JosefR/can-node/README.md

# can-node

A simple STM32F072 evaluation board with temperature and humidity sensors and a CAN interface. 

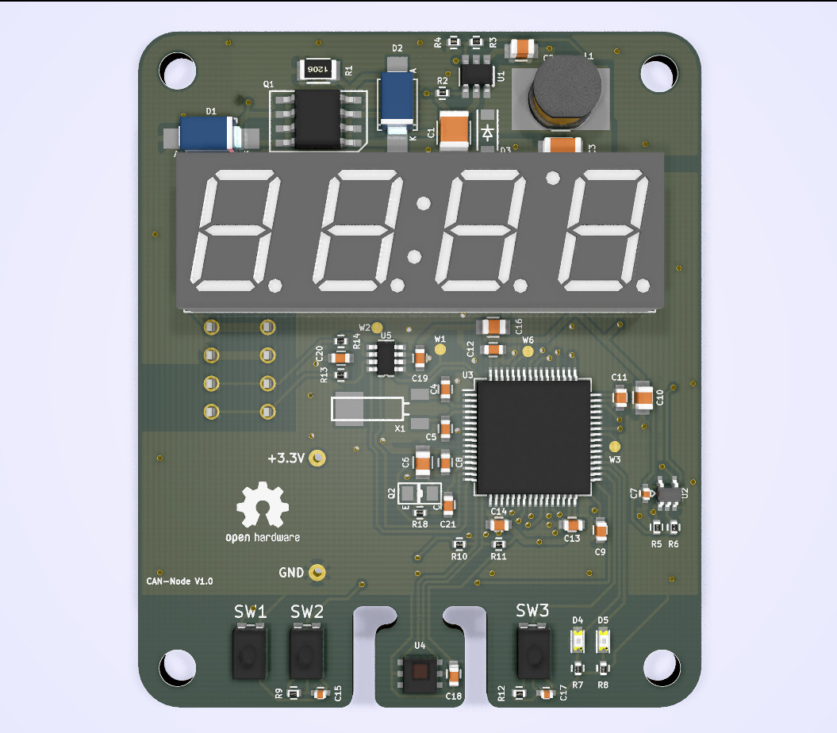
[picture p1: can-node.jpg]
can-node board
