JosefR/can-node/bom.ods

Reference | Count | Part | Manufacturer | Manufacturer Part Number | Package | Distributor | Distributor link | Cost
AFF1 | 1 | 4 digit 7-segment LED display | Lite-On | LTC-4627JR |  | Mouser | http://www.mouser.de/ProductDetail/Lite-On/LTC-4627JR/ | 1.85 | 1.85 |  | M | 5
C1 | 1 | 2.2 µF, >40V | Murata | GRM32ER72A225KA35L | 1210 | Reichelt | http://www.reichelt.de/Vielschicht-SMD-G1210-High-Cap/X7R-G1210-2-2/3/index.html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 | 0.3 | 0.3
C2 | 1 | 100 nF >10V | Yageo | CC0805KRX7R9BB104 | 0805 | Reichelt | http://www.reichelt.de/Vielschicht-SMD-G0805/X7R-G0805-100N/3/index.html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 | 0.04 | 0.04
C20 | 1 | 4,7nF | Yageo | CC0603KRX7R9BB472 | 0603 | Reichelt | http://www.reichelt.de/Vielschicht-SMD-G0603/X7R-G0603-4-7N/3/index.html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 | 0.04 | 0.04
C3 | 1 | 22µF | MuRata | GRM31CR71A226KE15L | 1206 | Reichelt | http://www.reichelt.de/Vielschicht-SMD-G1206-High-Cap/X7R-G1206-22-10/3/index.html?ACTION=3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 | 0.19 | 0.19
C4, C5 | 2 | 15pF | Wurth | 885012006052 | 0603 | Mouser | http://www.mouser.de/Search/ProductDetail.aspx | 0.057 | 0.114 |  | M | 12
C6, C10, C16 | 3 | 4.7µF | Yageo | CC0805KRX7R9BB472 | 0805 | Reichelt | http://www.reichelt.de/Vielschicht-SMD-G0805/X7R-G0805-4-7N/3/index.html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 | 0.04 | 0.12
C7, C8, C9, C11, C12, C13, C14, C15, C17, C18, C19, C21 | 12 | 100nF | Yageo | CC0603KRX7R7BB104 | 0603 | Mouser | http://www.mouser.de/ProductDetail/Yageo/CC0603KRX7R7BB104/ | 0.094 | 1.128 |  | M | 100
C22 | 1 | 0.1F |  |  | 10mm pitch | Reichelt | http://www.reichelt.de/Speicher-Elkos/SPK-100-000-10/3/index.html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 | 0.99 | 0.99
D1 | 1 | TVS-Diode, 40.2 V | Vishay | P4SMA47CA | DO-214AC | Mouser | http://www.mouser.de/ProductDetail/Vishay-Semiconductors/P4SMA47CA-E3-61/ | 0.377 | 0.377 |  | M | 7
D2 | 1 | Zener Diode 10V | ON Semiconductor | 1SMA5925BT3G | SMA | Mouser | http://www.mouser.de/ProductDetail/ON-Semiconductor/1SMA5925BT3G/ | 0.358 | 0.358 |  | M | 7
D3 | 1 | 0.57V 1A | NXP Semiconductor | PMEG6010CEH,11 | SOD-123F | Mouser | http://www.mouser.de/ProductDetail/NXP/PMEG6010CEH115/ | 0.358 | 0.358 | M | M | 7
D4,D5 | 2 | LED Rot | Osram |  | 0603 | Reichelt | http://www.reichelt.de/SMD-LEDs-Standard/LS-Q976/3/index.html?ACTION=3&GROUPID=3035&ARTICLE=156367&OFFSET=75 | 0.06 | 0.12
D6 | 1 | Schottky Diode 0.3V | Fairchield | MBR1020VL | SOD-123 | Mouser | http://www.mouser.de/ProductDetail/Fairchild-Semiconductor/MBR1020VL/ | 0.368 | 0.368 |  | M | 10
L1 | 1 | 27µH | Bourns | SDE0604A-270M |  | Mouser | http://www.mouser.de/ProductDetail/Bourns/SDE0604A-270M/ | 0.474 | 0.474 |  | M | 5
P1 | 1 | Micro Match Header 2x5 |  |  |  | Reichelt | http://www.reichelt.de/Micro-Match-Verbinder/MPE-374-1-010/3/index.html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 | 0.41 | 0.41
P2 | 1 |  | WAGO | 218-104 |  | Voelkner | http://www.voelkner.de/products/55717/Leiterplattenklemme-218-4-polig-Rm-2-5.html?products_model=D57985 | 2.08 | 2.08
Q1 | 1 | P-Mos | Diodes Incorporated | DMP6023LSS |  | Mouser | http://www.mouser.de/ProductDetail/Diodes-Incorporated/DMP6023LSS-13/?qs=jXf%2FRVhl83Yh%252bCazOhYmSQ%3D%3D | 0.74 | 0.74 |  | M | 5
Q2 | 1 | Fototransistor | Osram | SFH 3711 |  | Mouser | http://www.mouser.de/ProductDetail/Osram-Opto-Semiconductor/SFH-3711/ | 0.61 | 0.61 |  | M | 5
Q3, Q4, Q5, Q6, Q7, Q8, Q9, Q10 | 8 | N-Mos |  | BSS138 | SOT-23 | Reichelt | http://www.reichelt.de/BS-Transistoren/BSS-138-SMD/3/index.html?ACTION=3&GROUPID=2884&ARTICLE=41437&OFFSET=75 | 0.05 | 0.4
Q11, Q12, Q13, Q14, Q15 | 5 | P-Mos |  | BSS64P | SOT-23 | Reichelt | http://www.reichelt.de/BS-Transistoren/BSS-84P-SMD/3/index.html?ACTION=3&GROUPID=2884&ARTICLE=41443&OFFSET=75 | 0.05 | 0.25
R1 | 1 | 100 kΩ, >=0.1W | Yageo | RC1206JR-07100KL | 1206 | Reichelt | http://www.reichelt.de/SMD-1206-von-1-bis-910-kOhm/SMD-1-4W-100K/3/index.html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 | 0.03 | 0.03
R13, R14 | 2 | 60.4 kΩ | Vishay Dale | CRCW040260R4FKED | 0402 | Mouser | http://www.mouser.de/ProductDetail/Vishay/CRCW040260R4FKED/ | 0.094 | 0.188 |  | M | 10
R18 | 1 | 4.7 kΩ | Yageo | RC0402FR-074K7L | 0402 | Reichelt | http://www.reichelt.de/SMD-0402-von-1-bis-910-kOhm/SMD-0402-4-7K/3/index.html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 | 0.03 | 0.03
R2 | 1 | 100 kΩ, 5% | Yageo | RC0402FR-07100KL | 0402 | Reichelt | http://www.reichelt.de/SMD-0402-von-1-bis-910-kOhm/SMD-0402-100K/3/index.html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 | 0.03 | 0.03
R25, R26, R27, R28, R33, R34, R35, R36 | 8 | 120 Ω | Yageo | RC0402FR-07120RL | 0402 | Reichelt | http://www.reichelt.de/SMD-0402-von-0-bis-910-Ohm/SMD-0402-120/3/index.html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 | 0.03 | 0.24
R3 | 1 | 28 kΩ, 1% | Vishay Dale | CRCW040228K0FKED | 0402 | Mouser | http://www.mouser.de/ProductDetail/Vishay/CRCW040228K0FKED/?qs=sGAEpiMZZMu61qfTUdNhG2DpbjADlD3GUol6Srswoic%3d | 0.094 | 0.094 |  | M | 10
R4 | 1 | 8.45 kΩ, 1% | Vishay Dale | CRCW04028K45FKED | 0402 | Mouser | http://www.mouser.de/ProductDetail/Vishay/CRCW04028K45FKED/ | 0.094 | 0.094 |  | M | 10
R5, R6 | 2 | 10 kΩ | Yageo | RC0402FR-0710KL | 0402 | Reichelt | http://www.reichelt.de/SMD-0402-von-1-bis-910-kOhm/SMD-0402-10K/3/index.html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 | 0.03 | 0.06
R7, R8 | 2 | 220 Ω | Yageo | RC0402FR-07220RL | 0402 | Reichelt | http://www.reichelt.de/SMD-0402-von-0-bis-910-Ohm/SMD-0402-220/3/index.html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 | 0.03 | 0.06
R9, R10, R11, R12 | 2 | 3.3 kΩ | Yageo | RC0402FR-073K3L | 0402 | Reichelt | http://www.reichelt.de/SMD-0402-von-1-bis-910-kOhm/SMD-0402-3-3K/3/index.html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 | 0.03 | 0.06
R15 | 1 | 100 Ω > 0.11W | Yageo | RC0805FR-07100RL | 0805 | Reichelt | http://www.reichelt.de/SMD-0805-von-0-bis-910-Ohm/SMD-0805-100/3/index.html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 | 0.3 | 0.3
SW1, SW2, SW3 | 3 | Button |  |  | KMR2 | Reichelt | http://www.reichelt.de/Kurzhubtaster/KMR-231-G-LFS/3/index.html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 | 0.25 | 0.75
U1 | 1 | LMR16006 | Texas Instruments | LMR16006XDDCR | TI-DDC | Mouser | http://www.mouser.de/ProductDetail/Texas-Instruments/LMR16006XDDCR/ | 2.7 | 2.7
U2 | 1 | SN74LVC1G08 | Texas Instruments | SN74LVC1G08DCKR | TI-DCK | Mouser | http://www.mouser.de/ProductDetail/Texas-Instruments/SN74LVC1G08DCKR/ | 0.387 | 0.387
U3 | 1 | STM32F072RB | ST Microelectronics | STM32F072RBT6 | LQFP64 | Mouser | http://www.mouser.de/ProductDetail/STMicroelectronics/STM32F072RBT6/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 | 3.7 | 3.7
U4 | 1 | HDC1080 | Texas Instruments |  | DMB | Mouser | http://www.mouser.de/ProductDetail/Texas-Instruments/HDC1080DMBR/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 | 2.7 | 2.7
U5 | 1 | TCAN334 | Texas Instruments | TCAN334DCNT | TI-DCN | Mouser | http://www.mouser.de/ProductDetail/Texas-Instruments/TCAN334DCNT/ | 2.26 | 2.26
X1 | 1 | 32,768kHz, 12.5pF | MICRO CRYSTAL | MS1V-T1K 32.768KHZ 12,5PF |  | Reichelt | http://www.reichelt.de/Uhrenquarze-SMD-Gehaeuse/32-768-MS1V-12-5/3/index.html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 | 0.39 | 0.39
 |  |  |  |  |  |  |  |  | 25.39
