JosefR/can-node/case/thermostat.fcstd

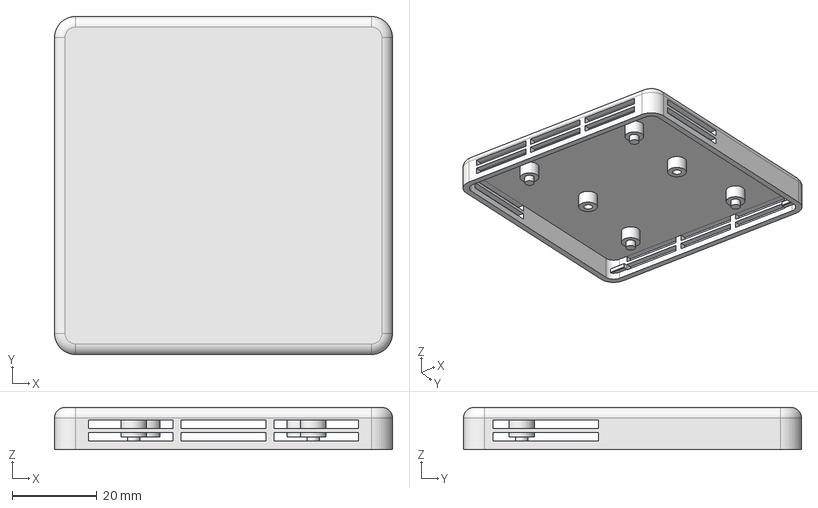
[picture p2: CAD file, 2016-12-29]
case/thermostat.fcstd
80.0 x 80.0 x 10.0 mm
