JosefR/can-node/can-node.kicad_pcb

## KiCad design can-node.kicad_pcb (2018-07-14)

Schematic: can-node.sch, CAN Node

Parts:
P2: CONN_01X04; WAGO_218-104

Connections:
CANH_IN: P2.4; also elsewhere on the board
CANL_IN: P2.3; also elsewhere on the board
GND: P2.2; also elsewhere on the board
VIN+: P2.1; also elsewhere on the board

Schematic: power.sch, CAN Node

Parts:
C1: 2.2µF; C_2010_5025Metric_Pad1.52x2.65mm_HandSolder
C2: 100n >10V; C_0603_1608Metric_Pad1.05x0.95mm_HandSolder; Rating >10V
C3: 22µF; C_1206_3216Metric_Pad1.42x1.75mm_HandSolder
C22: 0.1F; C_Radial_D13_L7_P10
D1: 40.2V; D_SMA_Handsoldering; Part P4SMA47CA
D2: 1A, 50V; D_SMF_Handsoldering; MPN SS1FN6
D3: 0.57V 1A; D_SOD-123_HandSoldering
D6: 0.3V; D_SOD-123_HandSoldering
L1: 27µH 220mΩ; SDE0604A_HandSoldering
R2: 100k; R_0603_1608Metric_Pad1.05x0.95mm_HandSolder
R3: 28k 1%; R_0603_1608Metric_Pad1.05x0.95mm_HandSolder
R4: 8.45k 1%; R_0603_1608Metric_Pad1.05x0.95mm_HandSolder
R15: 100; R_0805_2012Metric_Pad1.33x1.40mm_HandSolder
U1: LMR16006; TI-DDC_HandSoldering
W8: VINB; Measurement_Point_tiny
W9: VINC; Measurement_Point_tiny
W10: FB; Measurement_Point_tiny
W11: SW; Measurement_Point_tiny
W12: +3.3V; Measurement_Point_tiny
W15: 3.3V; TH-Pad_1.5mm
W19: GND; TH-Pad_1.5mm

Connections:
+BATT: D6.1 (K), R15.1; also elsewhere on the board
/Power Supply/VIN: C1.1, D2.1 (K), R2.1, U1.5, W8.1, W9.1
GND: C1.2, C3.2, C22.2, D1.2, D3.2 (A), R4.2, U1.2, W19.1; also elsewhere on the board
unnamed: C2.1, D3.1 (K), L1.1, U1.6, W11.1
unnamed: C2.2, U1.1
unnamed: C22.1, R15.2
unnamed: R2.2, U1.4
unnamed: R3.2, R4.1, U1.3, W10.1
VIN+: D1.1, D2.2 (A); also elsewhere on the board

Notes on the sheet:
9..24 V
3.3V 0.6A

Schematic: microcontroller.sch, CAN Node

Parts:
C4, C5: 15p; C_0603_1608Metric_Pad1.05x0.95mm_HandSolder
C6, C10, C16: 4µ7; C_0805_2012Metric_Pad1.33x1.40mm_HandSolder
C7, C8, C9, C11, C12, C13, C14, C15, C17, C18, C19: 100n; C_0603_1608Metric_Pad1.05x0.95mm_HandSolder
C20: 4n7; C_0603_1608Metric_Pad1.05x0.95mm_HandSolder
D4, D5: red; LED_0603_HandSoldering
P1: Debug; micromatch_smd_2x05
R5, R6: 10k; R_0603_1608Metric_Pad1.05x0.95mm_HandSolder
R7, R8: 220; R_0603_1608Metric_Pad1.05x0.95mm_HandSolder
R9, R12: 3.3k; R_0603_1608Metric_Pad1.05x0.95mm_HandSolder
R10, R11: 3k3; R_0603_1608Metric_Pad1.05x0.95mm_HandSolder
R13, R14: 60.4 1%; R_0603_1608Metric_Pad1.05x0.95mm_HandSolder
SW1, SW2, SW3: SW_PUSH; KMR2
U2: SN74LVC1G08; TI-DCK
U3: STM32F072RB; QFP-64_10x10_Pitch0.5mm_HandSoldering
U4: HDC1080; HDC1080_HandSoldering
U5: TCAN334; TI-DCN
W1: CAN_TX; Measurement_Point_tiny
W2: CAN_RX; Measurement_Point_tiny
W3: ~RST; Measurement_Point_tiny
W4: UART_RX; Measurement_Point_tiny
W5: UART_TX; Measurement_Point_tiny
W6: BOOT0; Measurement_Point_tiny
W16: SDA; Measurement_Point_tiny
W17: SCL; Measurement_Point_tiny
X1: 32.768KHz 12.5pF; Crystal-MS1V-T1K

Connections:
+BATT: U3.1; also elsewhere on the board
/Microcontroller/PA1: U3.15, U5.5
/Microcontroller/PA2: U3.16, U5.8
/Microcontroller/SWCLK: P1.4, U3.49
/Microcontroller/SWDIO: P1.3, U3.46
/Microcontroller/UART1_RX: P1.7, U3.43, W4.1; also elsewhere on the board
/Microcontroller/UART1_TX: P1.8, U3.42, W5.1; also elsewhere on the board
CANH_IN: R13.1, U5.7; also elsewhere on the board
CANL_IN: R14.2, U5.6; also elsewhere on the board
GND: C4.2, C5.2, C6.2, C7.2, C8.2, C9.2, C10.2, C11.2, C12.2, C13.2, C14.2, C15.2, C16.2, C17.2, C18.2, C19.2, C20.2, P1.9, P1.10, R7.1, R8.1, SW1.2, SW2.1, SW3.1, U2.3, U3.12, U3.18, U3.31, U3.47, U3.63, U4.2, U5.2; also elsewhere on the board
unnamed: C4.1, U3.3, X1.2
unnamed: C5.1, U3.4, X1.1
unnamed: C9.1, U2.4, U3.7, W3.1
unnamed: C15.1, R9.2, U3.33
unnamed: C17.1, R12.2, U3.34
unnamed: C20.1, R13.2, R14.1
unnamed: D4.1, R7.2
unnamed: D4.2, U3.35
unnamed: D5.1, R8.2
unnamed: D5.2, U3.36
unnamed: P1.5, R6.2, U2.2
unnamed: R5.2, SW1.1, U2.1
unnamed: R9.1, SW2.2
unnamed: R10.2, U3.30, U4.1, W16.1
unnamed: R11.2, U3.29, U4.6, W17.1
unnamed: R12.1, SW3.2
unnamed: U3.60, W6.1
unnamed: U3.61, U5.4, W2.1
unnamed: U3.62, U5.1, W1.1
PC0: U3.8; also elsewhere on the board
PC1: U3.9; also elsewhere on the board
PC2: U3.10; also elsewhere on the board
PC3: U3.11; also elsewhere on the board
PC4: U3.24; also elsewhere on the board
PC5: U3.25; also elsewhere on the board
PC6: U3.37; also elsewhere on the board
PC7: U3.38; also elsewhere on the board
PC8: U3.39; also elsewhere on the board
PC9: U3.40; also elsewhere on the board
PC10: U3.51; also elsewhere on the board
PC11: U3.52; also elsewhere on the board
PC12: U3.53; also elsewhere on the board

Schematic: display.sch, CAN Node

Parts:
AFF1: LTC-4627
Q3, Q4, Q5, Q6, Q7, Q8, Q9, Q10: BSS138; SOT-23_Handsoldering
Q11, Q12, Q13, Q14, Q15: BSS84P; SOT-23_Handsoldering
R25, R26, R27, R28, R33, R34, R35, R36: 120; R_0603_1608Metric_Pad1.05x0.95mm_HandSolder

Connections:
GND: Q3.2 (S), Q4.2 (S), Q5.2 (S), Q6.2 (S), Q7.2 (S), Q8.2 (S), Q9.2 (S), Q10.2 (S); also elsewhere on the board
unnamed: AFF1.1, Q11.3
unnamed: AFF1.2, Q12.3
unnamed: AFF1.3, R28.1
unnamed: AFF1.4, Q15.3
unnamed: AFF1.5, R33.1
unnamed: AFF1.6, Q13.3
unnamed: AFF1.7, R36.1
unnamed: AFF1.8, Q14.3
unnamed: AFF1.11, R34.1
unnamed: AFF1.13, R27.1
unnamed: AFF1.14, R25.1
unnamed: AFF1.15, R35.1
unnamed: AFF1.16, R26.1
unnamed: Q3.3 (D), R25.2
unnamed: Q4.3 (D), R26.2
unnamed: Q5.3 (D), R27.2
unnamed: Q6.3 (D), R28.2
unnamed: Q7.3 (D), R33.2
unnamed: Q8.3 (D), R34.2
unnamed: Q9.3 (D), R35.2
unnamed: Q10.3 (D), R36.2
PC0: Q3.1 (G); also elsewhere on the board
PC1: Q4.1 (G); also elsewhere on the board
PC2: Q5.1 (G); also elsewhere on the board
PC3: Q6.1 (G); also elsewhere on the board
PC4: Q7.1 (G); also elsewhere on the board
PC5: Q8.1 (G); also elsewhere on the board
PC6: Q9.1 (G); also elsewhere on the board
PC7: Q10.1 (G); also elsewhere on the board
PC8: Q11.1; also elsewhere on the board
PC9: Q12.1; also elsewhere on the board
PC10: Q13.1; also elsewhere on the board
PC11: Q14.1; also elsewhere on the board
PC12: Q15.1; also elsewhere on the board

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
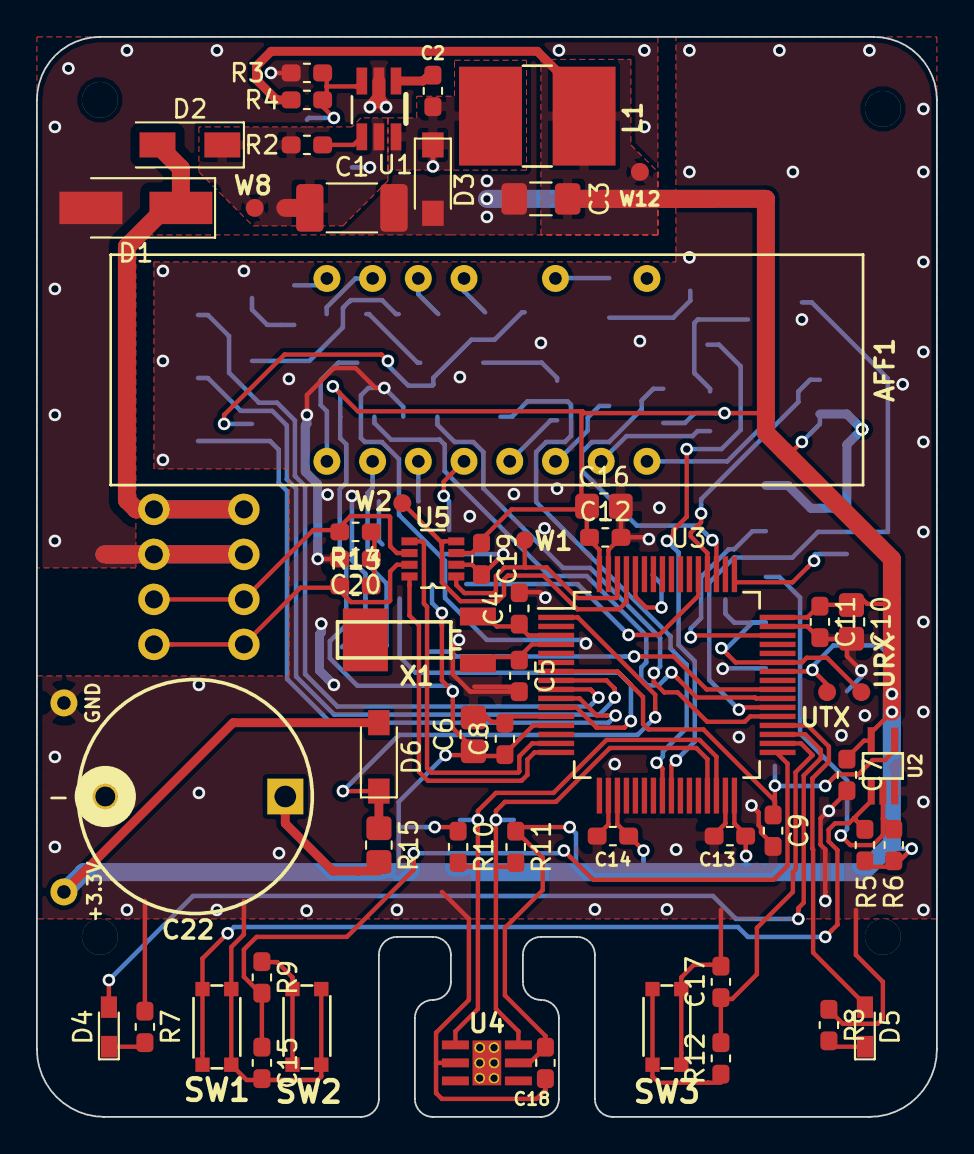
[picture p7: board can-node.kicad_pcb from above]

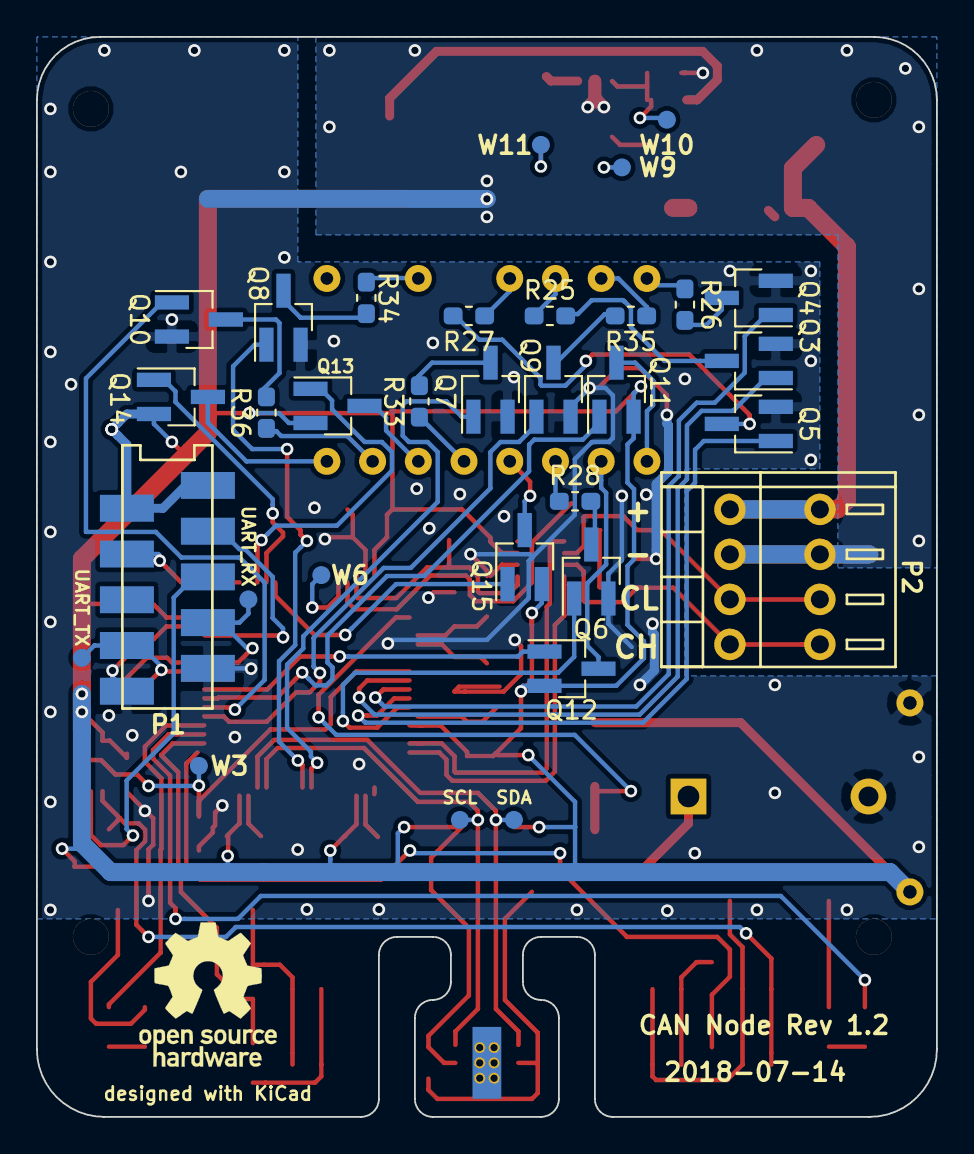
[picture p8: board can-node.kicad_pcb from below]

Board: 2 copper layers, 50.0 x 60.0 mm, 92 parts (32 on the bottom side), 71 nets.

Other parts of the board:
URX: UART_RX; Measurement_Point_tiny
UTX: UART_TX; Measurement_Point_tiny

Their connections:
/Microcontroller/UART1_RX: URX.1; also elsewhere on the board
/Microcontroller/UART1_TX: UTX.1; also elsewhere on the board
