JosefR/can-node/(commit log)

2015-10-28 A CAN node based on a STM32F072.
    [can-node.sch, can.sch, microcontroller.sch, power.sch]
2015-11-02 Use LT8609 for power supply.
    [can-node.sch, can.sch, microcontroller.sch, power.sch]
2015-11-02 Reverse voltage protection.
    [power.sch]
2015-11-07 changes on power supply; start redesign 3.3V rail
    [microcontroller.sch, power.sch]
2016-08-13 Basic schematic with temparature and humidity sensor.
    [can-node.sch, can.sch, connector.sch, microcontroller.sch, power.sch]
2016-08-13 Add flash and debug connector.
    [microcontroller.sch]
2016-08-20 HDC1080 footprint
2016-08-20 Use TPS5401 converter
    [power.sch]
2016-08-26 Use TI TCAN334 3.3V CAN transceiver.
    [can.sch, microcontroller.sch, power.sch]
2016-08-26 Remove 5V supply
    [power.sch]
2016-08-27 Reset circuit, minor changes
    [can.sch, connector.sch, microcontroller.sch, power.sch]
2016-09-02 24 V input protection
    [can.sch, microcontroller.sch, power.sch]
2016-09-02 Zener diode data sheet
2016-09-03 Add bom, minor changes
    [bom.ods, can.sch, connector.sch, microcontroller.sch, power.sch]
2016-09-10 Bom work
    [bom.ods, power.sch]
2016-09-10 Use LMR16006 DCDC
    [can.sch, connector.sch, microcontroller.sch, power.sch]
2016-09-17 Power supply work
    [power.sch]
2016-09-17 Remove power good logic
    [microcontroller.sch, power.sch]
2016-10-28 Finish BOM, assign and add packages, set connectors, minor changes
    [bom.ods, can.sch, connector.sch, microcontroller.sch, power.sch]
2016-10-29 Start PCB layout
    [can-node.kicad_pcb]
2016-10-29 Use WAGO 218-106 connector
    [can-node.kicad_pcb, connector.sch]
2016-10-29 Use solder jumper for optional CAN termination, fix crystal symbol
    [can-node.kicad_pcb, can.sch, microcontroller.sch]
2016-10-31 Layouting ...
    [can-node.kicad_pcb, can.sch]
2016-11-03 Layout: first version
    [bom.ods, can-node.kicad_pcb, can.sch, connector.sch, microcontroller.sch]
2016-11-03 Add case CAD file
    [thermostat.fcstd]
2016-11-03 Fix drill holes for thermal vias of HDC1080
    [can-node.kicad_pcb]
2016-11-03 Gerber and drill files
    [can-node-B.Cu.gbr, can-node-B.Mask.gbr, can-node-B.SilkS.gbr, can-node-Edge.Cuts.gbr, can-node-F.Cu.gbr, can-node-F.Mask.gbr, can-node-F.SilkS.gbr, can-node.drl]
2016-11-19 Use micro match for debug connector.
    [can-node-B.Cu.gbr, can-node-B.Mask.gbr, can-node-B.SilkS.gbr, can-node-Dwgs.User.gbr, can-node-Edge.Cuts.gbr, can-node-F.Cu.gbr, can-node-F.Mask.gbr, can-node-F.SilkS.gbr]
2016-12-03 Add measurement points, copyright label, minor changes.
    [can-node-B.Cu.gbr, can-node-B.Mask.gbr, can-node-B.SilkS.gbr, can-node-Dwgs.User.gbr, can-node-Edge.Cuts.gbr, can-node-F.Cu.gbr, can-node-F.Mask.gbr, can-node-F.SilkS.gbr]
2016-12-03 Minor changes (silkscreen)
    [can-node-B.Cu.gbr, can-node-B.Mask.gbr, can-node-B.SilkS.gbr, can-node-Dwgs.User.gbr, can-node-Edge.Cuts.gbr, can-node-F.Cu.gbr, can-node-F.Mask.gbr, can-node-F.SilkS.gbr]
2016-12-03 Update image, generate gerber again.
    [can-node-B.Cu.gbr, can-node-B.Mask.gbr, can-node-B.SilkS.gbr, can-node-Dwgs.User.gbr, can-node-Edge.Cuts.gbr, can-node-F.Cu.gbr, can-node-F.Mask.gbr, can-node-F.SilkS.gbr]
2016-12-03 Add schematic pdf.
2016-12-28 Add ambient light sensor, minor layout optimizations.
    [can-node.kicad_pcb, can-node.sch, can.sch, connector.sch, microcontroller.sch, power.sch]
2016-12-28 Add missing schematic changes.
    [can.sch, connector.sch, microcontroller.sch]
2016-12-29 Case modelling work
    [thermostat.fcstd]
2017-01-05 Some modifications to schematic, BOM, start releayout
    - add LED display
    - change crystal for RTC
    - use components that are available at some distributors
    [bom.ods, can-node.kicad_pcb, can-node.sch, can.sch, connector.sch, display.sch, microcontroller.sch, power.sch]
2017-01-05 Layouting work
    [can-node.kicad_pcb, display.sch, microcontroller.sch]
2017-01-07 Remove spi connector.
    [can-node.kicad_pcb, display.sch, microcontroller.sch]
2017-01-10 Add 24V outputs.
    [can-node-B.Cu.gbr, can-node-B.Mask.gbr, can-node-B.SilkS.gbr, can-node-Dwgs.User.gbr, can-node-Edge.Cuts.gbr, can-node-F.Cu.gbr, can-node-F.Mask.gbr, can-node-F.SilkS.gbr]
2017-01-11 Remove unnecessary 24V out, minor changes.
    [can-node-B.Cu.gbr, can-node-B.Mask.gbr, can-node-B.SilkS.gbr, can-node-Dwgs.User.gbr, can-node-Edge.Cuts.gbr, can-node-F.Cu.gbr, can-node-F.Mask.gbr, can-node-F.SilkS.gbr]
2017-01-11 Minor changes.
    [bom.ods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]
2017-01-12 No real changes
    [can-node-B.Cu.gbr, can-node-B.Mask.gbr, can-node-B.SilkS.gbr, can-node-Dwgs.User.gbr, can-node-Edge.Cuts.gbr, can-node-F.Cu.gbr, can-node-F.Mask.gbr, can-node-F.SilkS.gbr]
2017-01-13 Add buffer capacitor for RTC.
    [bom.ods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]
2017-02-20 Add schematic pdf and updated BOM.
    [bom.ods]
2018-04-30 Update for KiCad 5. Assign hand solder foot prints.
    [can-node.sch, display.sch, microcontroller.sch, power.sch]
2018-05-01 Make the board more hand solder friendly.
    [can-node-B.Cu.gbr, can-node-B.Mask.gbr, can-node-B.SilkS.gbr, can-node-Dwgs.User.gbr, can-node-Edge.Cuts.gbr, can-node-F.Cu.gbr, can-node-F.Mask.gbr, can-node-F.SilkS.gbr]
2018-05-02 Add mounting holes.
    [can-node-B.Cu.gbr, can-node-B.Mask.gbr, can-node-B.SilkS.gbr, can-node-Dwgs.User.gbr, can-node-Edge.Cuts.gbr, can-node-F.Cu.gbr, can-node-F.Mask.gbr, can-node-F.SilkS.gbr]
2018-05-02 Create pdf of schematic.
    [can-node.sch, display.sch, microcontroller.sch, power.sch]
2018-07-13 Update for KiCad 5.
    [can-node.sch, display.sch, microcontroller.sch, power.sch]
2018-07-14 Simplify over voltage protection and improve PCB.
    - use new KiCad library for some parts
    [can-node.kicad_pcb, display.sch, microcontroller.sch, power.sch]
2018-07-14 Replace remaining parts from old KiCad library.
    [can-node.kicad_pcb]
2018-09-01 Update Gerber files.
    [can-node-B.Cu.gbr, can-node-B.Mask.gbr, can-node-B.SilkS.gbr, can-node-Dwgs.User.gbr, can-node-Edge.Cuts.gbr, can-node-F.Cu.gbr, can-node-F.Mask.gbr, can-node-F.SilkS.gbr]
